Dakyodream/orbtrace_hw/hw/orbtrace_m26/net_length.md

# Net length

26.4998

26.5

DI: 12.9525
DO: 13.1981
CK: 13.1911
MS: 12.825

Trace
CLK 23.7894
D0 9.0235
D1 9.9449
D2 7.0862
D3 7.7114

26,5
26.656
