Dakyodream/orbtrace_hw/hw/orbtrace_m26/orbtrace_m26/orbtrace_m26.kicad_pcb

## KiCad design hw/orbtrace_m26/orbtrace_m26/orbtrace_m26.kicad_pcb (2026-08-20)

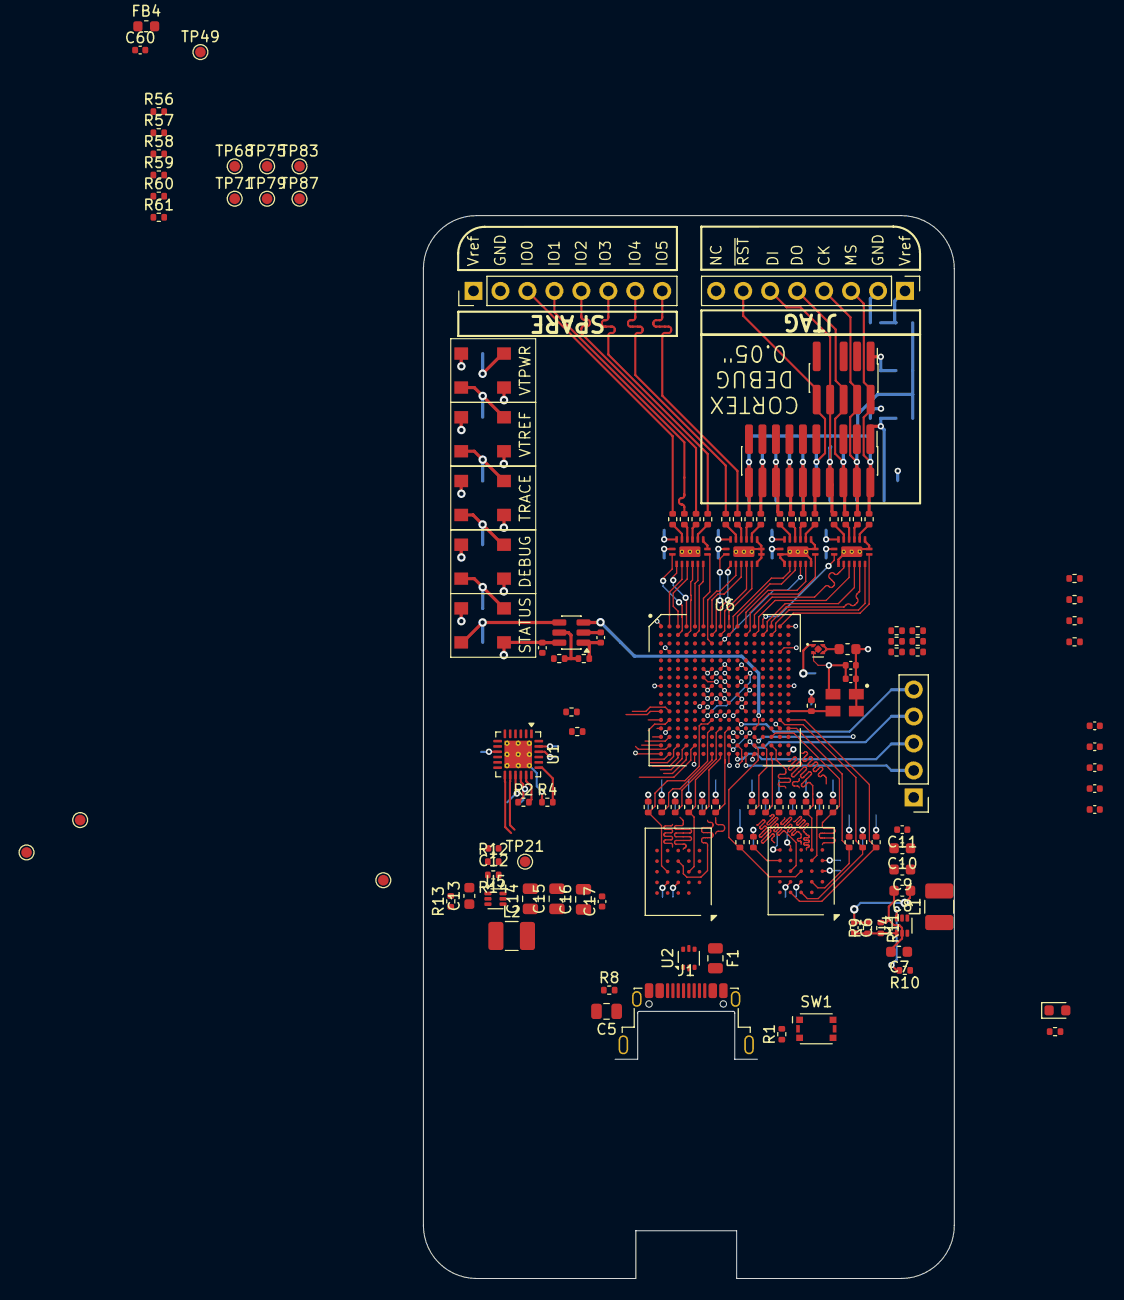
[picture p13: board orbtrace_m26.kicad_pcb from above]

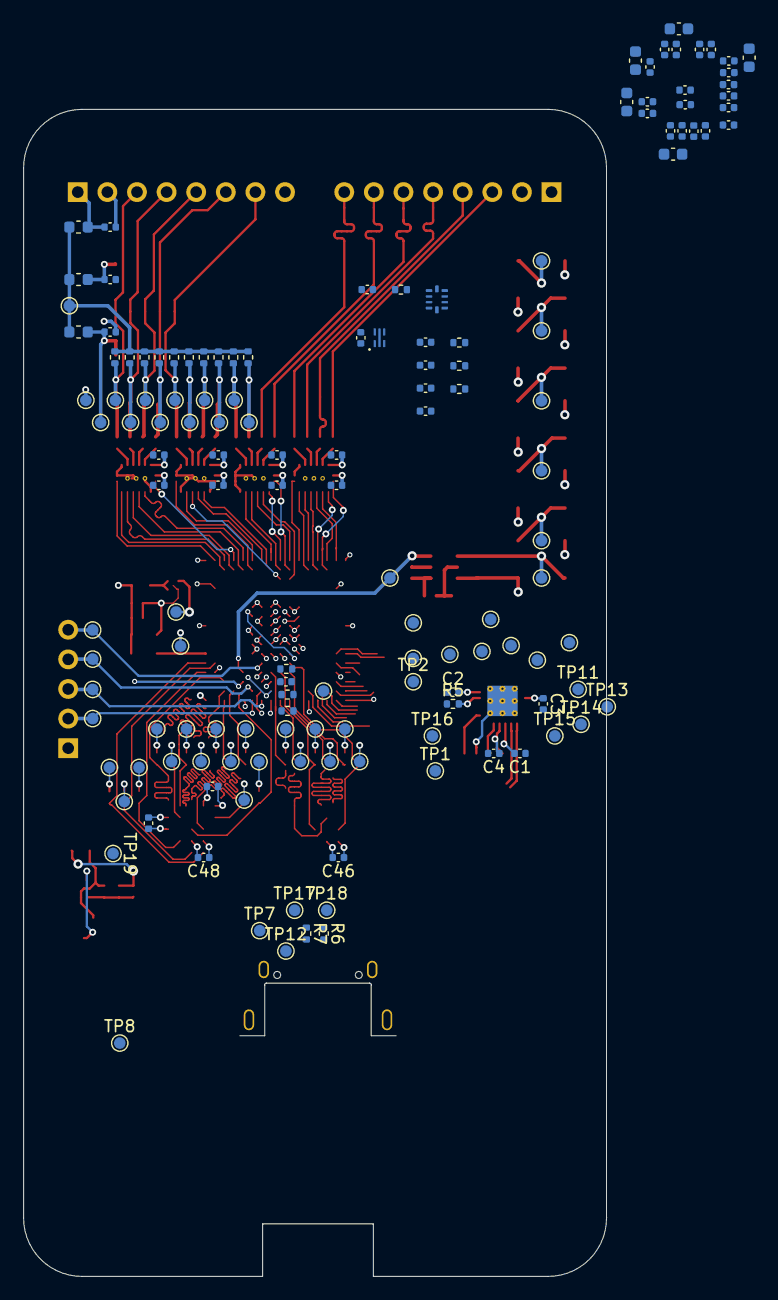
[picture p14: board orbtrace_m26.kicad_pcb from below]

Board: 4 copper layers, 50.0 x 100.1 mm, 273 parts (141 on the bottom side), 161 nets.

Parts:
C1, C2, C11, C17, C44: 1µF; C_0402_1005Metric
C3, C4, C18, C22, C23, C24, C25, C26, C27, C29, C30, C32, C33, C34, C35, C36, C37, C38, C39, C40, C41, C42, C43, C45, C46, C47, C48, C49, C50, C51, C52, C53, C54, C55, C56, C57, C58, C59, C60, C61, C62, C71, C72, C73, C74, C75, C76, C77: 100nF; C_0402_1005Metric
C5: 4.7nF; C_0805_2012Metric
C6, C12: 6.8pF; C_0402_1005Metric
C7, C13: 4.7µF; C_0603_1608Metric
C8, C9, C10, C19, C20, C21, C28, C31: 10µF; C_0603_1608Metric
C14, C15, C16: 22µF; C_0805_2012Metric
C63, C64, C65, C66: 470nF; C_0402_1005Metric
D1: GREEN; LED_0603_1608Metric
F1: 500mA; Fuse_0805_2012Metric
FB1, FB2, FB3, FB4, FB5: MMZ1005Y121CT000; L_0603_1608Metric
J1: USB_C_Receptacle_USB2.0_16P; USB_C_Receptacle_Amphenol_12401948E412A
J2: Conn_01x05; PinHeader_1x05_P2.54mm_Vertical
J3, J4: Conn_01x08; PinHeader_1x08_P2.54mm_Vertical
L1, L2: 2.2µH; L_1210_3225Metric_Pad1.42x2.65mm_HandSolder
R1, R5: 10k; R_0402_1005Metric
R2: 20k; R_0402_1005Metric
R3: 180Ω; R_0402_1005Metric
R4: 8.06k; R_0402_1005Metric
R6, R7: 5.1k; R_0402_1005Metric
R8: 1M; R_0402_1005Metric
R9: 453k; R_0402_1005Metric
R10, R13: 475k; R_0402_1005Metric
R11, R14, R38, R39, R40, R41, R44, R49, R52, R53, R54, R55, R56, R57, R58, R59, R60, R61: 100k; R_0402_1005Metric
R12: 82.5k; R_0402_1005Metric
R15, R16, R17, R18, R19, R20, R21, R22, R23, R24, R25, R26: 4.7k; R_0402_1005Metric
R27, R28, R29, R68, R69, R70, R71, R72, R73, R74, R75, R76, R77, R78, R79, R80, R81, R82, R83, R84, R85, R86: 0Ω; R_0402_1005Metric
R30, R31, R32, R33, R34, R35, R36, R37, R42, R43, R45, R46, R47, R48, R50, R51: 100Ω; R_0402_1005Metric
R62, R63, R64, R65, R66, R67: 1K; R_0402_1005Metric
SW1: SW_Push_Shielded; SW_Wurth_WS-TASV_435151014824
TP1, TP2, TP3, TP4, TP5, TP6, TP7, TP8, TP9, TP10, TP11, TP12, TP13, TP14, TP15, TP16, TP17, TP18, TP19, TP20, TP21, TP22, TP23, TP24, TP25, TP26, TP27, TP28, TP29, TP30, TP31, TP32, TP33, TP34, TP35, TP36, TP37, TP38, TP39, TP40, TP41, TP42, TP43, TP44, TP45, TP46, TP47, TP48, TP49, TP52, TP53, TP56, TP59, TP62, TP65, TP68, TP69, TP71, TP72, TP75, TP76, TP79, TP80, TP83, TP84, TP87, TP93, TP94, TP95, TP96, TP97, TP98, TP99, TP100, TP101, TP102, TP103: TestPoint_Pad_D1.0mm
U1: USB3343; QFN-24-1EP_4x4mm_P0.5mm_EP2.6x2.6mm_ThermalVias
U2: USBLC6-2P6; SOT-666
U3: TLV71325PDQN; Texas_X2SON-4_1x1mm_P0.65mm
U4, U5: TLV62568PDRL; SOT-563
U6: LFE5U-25F-6BG256C; lattice_caBGA-256_ECP5
U7: M24128-BFMH; UFDFPN5
U8: W956A8MBYA5I; BGA-24_6x8mm_Layout5x5_P1.0mm
U9: S25FL064LABBHV020; BGA-24_6x8mm_Layout5x5_P1.0mm
U10: SWD-TRACE-FTSH110; PinSocket_2x10_P1.27mm_JTAG
U11, U12, U14, U15: SN74AVC4T774-Q1; TI-WQFN-BQB0016B
U13: SWD-FTSH105; PinSocket_2x05_P1.27mm_JTAG
U16: TLA2024; RUG0010A
U17: SN74LVC1T45DBV; SOT-23-6
U18, U19, U20, U21, U22: WL-ICLED; LED_RGB_Wuerth-PLCC4_5x5mm_WL-ICLED
Y1: 831025497; CFPS-39

Connections:
+1V1: C12.1, C14.1, C15.1, C16.1, C17.1, C19.1, C20.1, C21.1, C22.1, C23.1, C24.1, C25.1, C26.1, C27.1, L2.2, R12.2, R62.2, TP21.1 (1_1), U6.G6 (VCC), U6.G7 (VCC), U6.G9 (VCC), U6.L8 (VCC), U6.L9 (VCC), U6.L10 (VCC)
+2V5: C28.1, C29.1, C30.1, R63.2, TP20.1 (1_1), U3.1 (OUT), U6.G11 (VCCAUX), U6.L7 (VCCAUX)
+3.3V: C3.1, C6.1, C8.1, C9.1, C10.1, C11.1, C31.1, C32.1, C33.1, C34.1, C35.1, C36.1, C37.1, C38.1, C39.1, C40.1, C41.1, C42.1, C43.1, C46.1, C47.1, C48.1, C49.1, C50.1, C52.1, C55.1, C57.1, C71.1, FB1.1, L1.2, R1.2, R9.2, R15.2, R16.2, R17.2, R18.2, R19.2, R21.2, R22.2, R23.2, R24.2, R25.2, R26.2, R64.2, R66.2, TP19.1 (1_1), U1.2 (CLKOUT), U1.9 (VDDIO), U3.3 (EN), U3.4 (IN), U6.F6 (VCCIO0), U6.F7 (VCCIO0), U6.F10 (VCCIO1), U6.F11 (VCCIO1), U6.H6 (VCCIO7), U6.H7 (VCCIO7), U6.J6 (VCCIO6), U6.J7 (VCCIO6), U6.K11 (VCCIO3), U6.L6 (VCCIO8), U6.L11 (VCCIO3), U7.1 (VCC), U8.B4 (VCC), U8.D1 (VCCQ), U8.E4 (VCCQ), U9.B4 (VCC), U11.16 (VCCA), U12.16 (VCCA), U14.16 (VCCA), U15.16 (VCCA), U17.1 (VCCA)
+5V: C4.1, C7.1, C13.1, C61.1, C72.1, C73.1, C74.1, C75.1, C76.1, C77.1, F1.1, R2.1, R3.2, R10.1, R13.1, TP7.1 (1_1), U1.16 (VBAT), U2.5 (VBUS), U4.3 (VIN), U4.5 (EN), U5.3 (VIN), U5.5 (EN), U16.8 (VDD), U17.6 (VCCB), U18.3 (VDD), U19.3 (VDD), U20.3 (VDD), U21.3 (VDD), U22.3 (VDD)
/FPGA/DONE: R22.1, TP22.1 (1_1), U6.P9 (DONE)
/USB/VBUS: F1.2, J1.A4 (VBUS), J1.A9 (VBUS), J1.B4 (VBUS), J1.B9 (VBUS), TP12.1 (1_1)
BTN: R1.1, SW1.2, TP8.1 (1_1), U6.P12 (PR47D)
CFG0: R24.1, R26.1, R27.2, R29.2, U6.N10 (CFG_0), U6.R10 (CFG_2)
CFG1: R25.1, R28.2, U6.P10 (CFG_1)
DEBUG_JTCK: U6.B13 (PT60A), U11.5 (A3)
DEBUG_JTDI: U6.A12 (PT53B), U11.3 (A1)
DEBUG_JTDO: U6.B12 (PT56A), U11.4 (A2)
DEBUG_JTMS: U6.A14 (PT65B), U11.6 (A4)
DEBUG_NRST: U6.A11 (PT35A), U14.6 (A4)
DIR_JTCK: U6.B14 (PT67A), U11.7 (DIR3)
DIR_JTDI: U6.A13 (PT65A), U11.1 (DIR1)
DIR_JTMS: U6.A15 (PT67B), U11.8 (DIR4)
DIR_NRST: U6.B11 (PT49A), U14.8 (DIR4)
GND: C1.1, C2.1, C3.2, C4.2, C5.2, C7.2, C8.2, C9.2, C10.2, C11.2, C13.2, C14.2, C15.2, C16.2, C17.2, C18.2, C19.2, C20.2, C21.2, C22.2, C23.2, C24.2, C25.2, C26.2, C27.2, C28.2, C29.2, C30.2, C31.2, C32.2, C33.2, C34.2, C35.2, C36.2, C37.2, C38.2, C39.2, C40.2, C41.2, C42.2, C43.2, C44.2, C45.2, C46.2, C47.2, C48.2, C49.2, C50.2, C51.2, C52.2, C53.2, C54.2, C55.2, C56.2, C57.2, C58.2, C59.2, C60.2, C61.2, C62.2, C63.2, C64.2, C65.2, C66.2, C71.2, C72.2, C73.2, C74.2, C75.2, C76.2, C77.2, D1.1 (K), J1.A1 (GND), J1.A12 (GND), J1.B1 (GND), J1.B12 (GND), J2.1, J3.2, J4.2, R4.1, R5.1, R6.1, R7.1, R8.1, R11.1, R14.1, R20.1, R27.1, R28.1, R29.1, R67.1, SW1.1, SW1.SH (B), TP100.1 (1_1), TP101.1 (1_1), TP102.1 (1_1), U1.25 (GND), U2.2 (GND), U3.2 (GND), U3.5 (PAD), U4.2 (GND), U5.2 (GND), U6.A1 (GND), U6.A16 (GND), U6.D2 (GND), U6.D15 (GND), U6.F8 (GND), U6.F9 (GND), U6.G8 (GND), U6.G10 (GND), U6.H1 (GND), U6.H8 (GND), U6.H9 (GND), U6.H10 (GND), U6.H11 (VCCIO2), U6.H16 (GND), U6.J8 (GND), U6.J9 (GND), U6.J10 (GND), U6.J11 (VCCIO2), U6.K6 (GND), U6.K7 (GND), U6.K8 (GND), U6.K9 (GND), U6.K10 (GND), U6.N2 (GND), U6.N15 (GND), U6.T1 (GND), U6.T5 (GND), U6.T12 (GND), U6.T16 (GND), U7.2 (VSS), U7.5 (~WC), U8.B1 (~CLK), U8.B3 (VSS), U8.C1 (VSSQ), U8.E5 (VSSQ), U9.B3 (GND), U10.3 (GND), U10.5 (GND), U10.9 (GNDDET), U10.15 (GND), U10.17 (GND), U10.19 (GND), U11.2 (DIR2), U11.9 (~OE), U11.10 (GND), U11.17 (TP), U12.7 (DIR3), U12.8 (DIR4), U12.9 (~OE), U12.10 (GND), U12.17 (TP), U13.3 (GND), U13.5 (GND), U13.9 (GNDDET), U14.1 (DIR1), U14.2 (DIR2), U14.7 (DIR3), U14.9 (~OE), U14.10 (GND), U14.17 (TP), U15.9 (~OE), U15.10 (GND), U15.17 (TP), U16.1 (ADDR), U16.3 (GND), U17.2 (GND), U18.1 (GND), U19.1 (GND), U20.1 (GND), U21.1 (GND), U22.1 (GND), Y1.2 (GND)
HRAM_CLK: R77.1, U6.N16 (PR32A), U8.B2 (CLK)
HRAM_CS: R76.1, U6.M15 (PR26D), U8.A3 (~CS)
HRAM_DQ0: R78.1, U6.T15 (PR38D), U8.D3 (DQ0)
HRAM_DQ1: R79.1, U6.P13 (PR41A), U8.D2 (DQ1)
HRAM_DQ2: R80.1, U6.T14 (PR41D), U8.C4 (DQ2)
HRAM_DQ3: R81.1, U6.R13 (PR41C), U8.D4 (DQ3)
HRAM_DQ4: R82.1, U6.T13 (PR44B), U8.D5 (DQ4)
HRAM_DQ5: R83.1, U6.R14 (PR41B), U8.E3 (DQ5)
HRAM_DQ6: R84.1, U6.R15 (PR38C), U8.E2 (DQ6)
HRAM_DQ7: R85.1, U6.P14 (PR38B), U8.E1 (DQ7)
HRAM_RST: R74.1, U6.M16 (PR26C), U8.A4 (~RESET)
HRAM_RWDS: R75.1, U6.R12 (PR44A), U8.C3 (RWDS)
JTCK: J2.3, R20.2, TP36.1 (1_1), U6.T10 (TCK)
JTDI: J2.4, R18.1, TP40.1 (1_1), U6.R11 (TDI)
JTDO: J2.5, R19.1, TP44.1 (1_1), U6.M10 (TDO)
JTMS: J2.2, R17.1, TP32.1 (1_1), U6.T11 (TMS)
LED_DATA: TP93.1 (1_1), U6.N12 (PR44D), U17.3 (A)
LED_EXT: TP99.1 (1_1), U22.4 (DOUT)
LED_START: TP94.1 (1_1), U17.4 (B), U18.2 (DIN)
unnamed: D1.2 (A), R3.1
unnamed: J1.A5 (CC1), R6.2
unnamed: J1.B5 (CC2), R7.2
unnamed: C5.1, J1.SH (SHIELD), R8.2
unnamed: C60.1, FB4.2, J3.1, TP49.1 (1_1)
unnamed: C62.1, FB5.1, J4.1
unnamed: R68.2, TP28.1 (1_1)
unnamed: R69.2, TP30.1 (1_1)
unnamed: R70.2, TP33.1 (1_1)
unnamed: R71.2, TP37.1 (1_1)
unnamed: R72.2, TP41.1 (1_1)
unnamed: R73.2, TP45.1 (1_1)
unnamed: R74.2, TP34.1 (1_1)
unnamed: R75.2, TP38.1 (1_1)
unnamed: R76.2, TP42.1 (1_1)
unnamed: R77.2, TP46.1 (1_1)
unnamed: R78.2, TP26.1 (1_1)
unnamed: R79.2, TP27.1 (1_1)
unnamed: R80.2, TP29.1 (1_1)
unnamed: R81.2, TP31.1 (1_1)
unnamed: R82.2, TP35.1 (1_1)
unnamed: R83.2, TP39.1 (1_1)
unnamed: R84.2, TP43.1 (1_1)
unnamed: R85.2, TP47.1 (1_1)
unnamed: R86.2, TP23.1 (1_1)
unnamed: C1.2, U1.15 (VDD33), U1.18 (ID)
unnamed: R4.2, U1.19 (RBIAS)
unnamed: R2.2, U1.17 (VBUS)
unnamed: C2.2, U1.23 (VDD18)
unnamed: C6.2, R9.1, R11.2, U4.1 (FB)
unnamed: R10.2, U4.6 (PG)
unnamed: L1.1, U4.4 (SW)
unnamed: C12.2, R12.1, R14.2, U5.1 (FB)
unnamed: R13.2, U5.6 (PG)
unnamed: L2.1, U5.4 (SW)
unnamed: R23.1, U6.T9 (INITN)
unnamed: C54.1, FB2.1, TP103.1 (1_1), U10.1 (VTREF)
unnamed: R34.1, U11.14 (B1)
unnamed: R36.1, U11.13 (B2)
unnamed: R30.1, U11.12 (B3)
unnamed: R32.1, U11.11 (B4)
unnamed: R35.1, U12.14 (B1)
unnamed: R37.1, U12.13 (B2)
unnamed: R31.1, U12.12 (B3)
unnamed: R33.1, U12.11 (B4)
unnamed: C59.1, FB3.2, U13.1 (VTREF)
unnamed: R47.1, U14.14 (B1)
unnamed: R50.1, U14.13 (B2)
unnamed: R42.1, U14.12 (B3)
unnamed: R45.1, U14.11 (B4)
unnamed: R48.1, U15.14 (B1)
unnamed: R51.1, U15.13 (B2)
unnamed: R43.1, U15.12 (B3)
unnamed: R46.1, U15.11 (B4)
unnamed: C63.1, R62.1, U16.4 (AN0)
unnamed: C64.1, R63.1, U16.5 (AN1)
unnamed: C65.1, R64.1, U16.6 (AN2)
unnamed: C66.1, R65.1, U16.7 (AN3)
unnamed: R66.1, R67.2, U17.5 (DIR)
unnamed: TP95.1 (1_1), U18.4 (DOUT), U19.2 (DIN)
unnamed: TP96.1 (1_1), U19.4 (DOUT), U20.2 (DIN)
unnamed: TP97.1 (1_1), U20.4 (DOUT), U21.2 (DIN)
unnamed: TP98.1 (1_1), U21.4 (DOUT), U22.2 (DIN)
unnamed: C44.1, C45.1, FB1.2, Y1.1 (EN), Y1.4 (+Vs)
PROGRAMN: C18.1, R21.1, TP48.1 (1_1), U6.P11 (PR47C), U6.R9 (PROGRAMN)
QSPI_CS: R73.1, U6.N8 (PB15A), U9.C2 (~CS)
QSPI_IO0: R68.1, U6.T8 (PB11B), U9.D3 (IO0)
QSPI_IO1: R69.1, U6.T7 (PB11A), U9.D2 (IO1)
QSPI_IO2: R70.1, U6.M7 (PB9B), U9.C4 (IO2)
QSPI_IO3: R71.1, U6.N7 (PB9A), U9.D4 (IO3)
QSPI_SCK: R72.1, U6.N9 (CCLK), U9.B2 (CLK)
SCL: R15.1, TP25.1 (1_1), U6.L2 (PL26B), U7.4 (SCL), U16.10 (SCL)
SDA: R16.1, TP24.1 (1_1), U6.L1 (PL26A), U7.3 (SDA), U16.9 (SDA)
SPARE_DIR0: U6.B3 (PT4B), U15.1 (DIR1)
SPARE_DIR1: U6.A4 (PT6B), U15.2 (DIR2)
SPARE_DIR2: U6.B5 (PT15B), U15.7 (DIR3)
SPARE_DIR3: U6.A6 (PT18B), U15.8 (DIR4)
SPARE_DIR4: U6.B7 (PT27B), U12.1 (DIR1)
SPARE_DIR5: U6.A8 (PT29B), U12.2 (DIR2)
SPARE_IO0: U6.A2 (PT4A), U15.3 (A1)
SPARE_IO1: U6.A3 (PT6A), U15.4 (A2)
SPARE_IO2: U6.B4 (PT11B), U15.5 (A3)
SPARE_IO3: U6.A5 (PT18A), U15.6 (A4)
SPARE_IO4: U6.C7 (PT27A), U12.3 (A1)
SPARE_IO5: U6.A7 (PT29A), U12.4 (A2)
SYS_CLK: R86.1, U6.L16 (PR26A), Y1.3 (out)
TRACE_CLK: U6.C8 (PT35A), U14.5 (A3)
TRACE_D0: U6.A10 (PT42B), U14.4 (A2)
TRACE_D1: U6.B9 (PT38A), U14.3 (A1)
TRACE_D2: U6.A9 (PT42A), U12.6 (A4)
TRACE_D3: U6.B8 (PT35B), U12.5 (A3)
ULPI_CLK: TP1.1 (1_1), U1.21 (REFCLK/XI), U6.R5 (PL44A)
ULPI_DATA0: TP5.1 (1_1), U1.4 (DATA0), U6.T2 (PL38D)
ULPI_DATA1: TP6.1 (1_1), U1.5 (DATA1), U6.R2 (PL38C)
ULPI_DATA2: TP9.1 (1_1), U1.6 (DATA2), U6.R1 (PL35B)
ULPI_DATA3: TP10.1 (1_1), U1.7 (DATA3), U6.P2 (PL32B)
ULPI_DATA4: TP11.1 (1_1), U1.8 (DATA4), U6.P1 (PL35A)
ULPI_DATA5: TP13.1 (1_1), U1.10 (DATA5), U6.N1 (PL32A)
ULPI_DATA6: TP14.1 (1_1), U1.11 (DATA6), U6.M2 (PL26D)
ULPI_DATA7: TP15.1 (1_1), U1.12 (DATA7), U6.M1 (PL26C)
ULPI_DIR: TP4.1 (1_1), U1.1 (DIR), U6.T3 (PL41D)
ULPI_NXT: TP3.1 (1_1), U1.3 (NXT), U6.R3 (PL41B)
ULPI_RESET: R5.2, TP16.1 (1_1), U1.22 (~RESETB), U6.T4 (PL44B)
ULPI_STP: TP2.1 (1_1), U1.24 (STP), U6.R4 (PL41C)
USB_D_N: J1.A7 (D-), J1.B7 (D-), TP18.1 (1_1), U1.14 (DM), U2.1 (IO1), U2.6 (IO1)
USB_D_P: J1.A6 (D+), J1.B6 (D+), TP17.1 (1_1), U1.13 (DP), U2.3 (IO2), U2.4 (IO2)
VTREF: C51.1, C53.1, C56.1, C58.1, FB2.2, FB3.1, FB4.1, FB5.2, R38.2, R39.2, R40.2, R41.2, R44.2, R49.2, R52.2, R53.2, R54.2, R55.2, R56.2, R57.2, R58.2, R59.2, R60.2, R61.2, R65.2, TP52.1 (1_1), U11.15 (VCCB), U12.15 (VCCB), U14.15 (VCCB), U15.15 (VCCB)
VT_DEBUG_JTCK: J4.4, R30.2, R40.1, TP59.1 (1_1), U10.4 (SWCLK), U13.4 (SWCLK)
VT_DEBUG_JTDI: J4.6, R34.2, R44.1, TP65.1 (1_1), U10.8 (NC_(JTDI)), U13.8 (NC_(JTDI))
VT_DEBUG_JTDO: J4.5, R36.2, R41.1, TP62.1 (1_1), U10.6 (SWO), U13.6 (SWO)
VT_DEBUG_JTMS: J4.3, R32.2, R39.1, TP56.1 (1_1), U10.2 (SWDIO), U13.2 (SWDIO)
VT_DEBUG_NRST: J4.7, R38.1, R45.2, TP53.1 (1_1), U10.10 (NRST), U13.10 (NRST)
VT_SPARE_IO0: J3.3, R48.2, R56.1, TP68.1 (1_1)
VT_SPARE_IO1: J3.4, R51.2, R57.1, TP71.1 (1_1)
VT_SPARE_IO2: J3.5, R43.2, R58.1, TP75.1 (1_1)
VT_SPARE_IO3: J3.6, R46.2, R59.1, TP79.1 (1_1)
VT_SPARE_IO4: J3.7, R35.2, R60.1, TP83.1 (1_1)
VT_SPARE_IO5: J3.8, R37.2, R61.1, TP87.1 (1_1)
VT_TRACE_CLK: R42.2, R49.1, TP69.1 (1_1), U10.12 (VT_TRACECLK)
VT_TRACE_D0: R50.2, R52.1, TP72.1 (1_1), U10.14 (TRACED0)
VT_TRACE_D1: R47.2, R53.1, TP76.1 (1_1), U10.16 (TRACED1)
VT_TRACE_D2: R33.2, R54.1, TP80.1 (1_1), U10.18 (TRACED2)
VT_TRACE_D3: R31.2, R55.1, TP84.1 (1_1), U10.20 (TRACED3)
