Dakyodream/orbtrace_hw/hw/orbtrace_mini_bis_kicad/connector_70p.kicad_sch

## KiCad design hw/orbtrace_mini_bis_kicad/connector_70p.kicad_sch (2026-08-03)

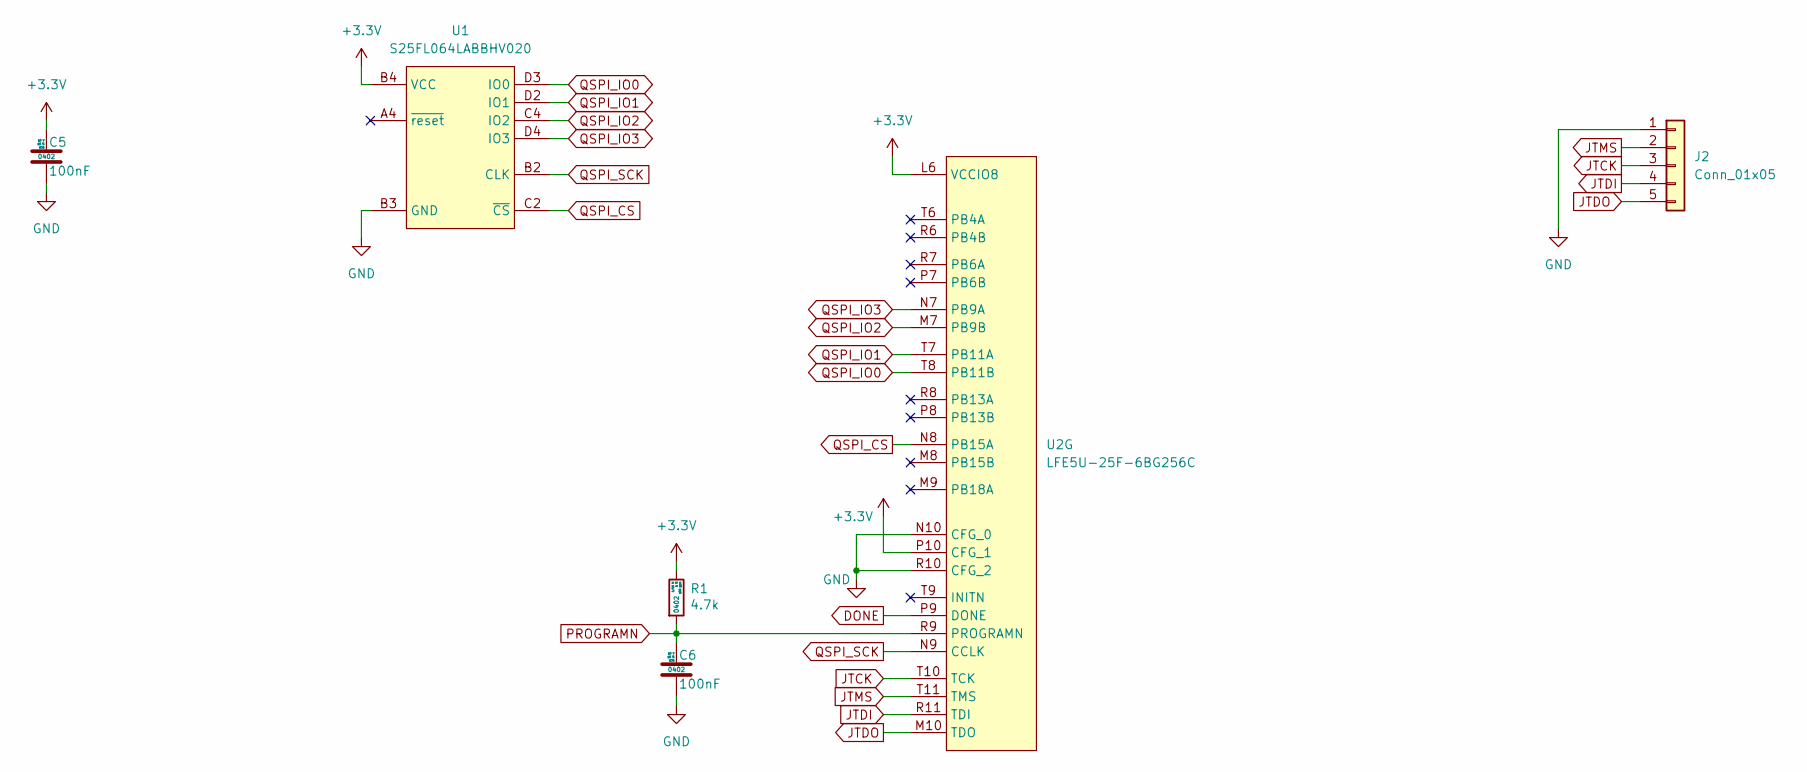
[picture p15: schematic connector_70p.kicad_sch]

Parts:
C5, C6: 100nF; Voltage rating DC 10 V; Tolerance 10 %
J2: Conn_01x05
R1: 4.7k; Tolerance 1 %
U1: S25FL064LABBHV020
U2: LFE5U-25F-6BG256C

Connections:
+3.3V: C5.1, R1.2, U1.B4 (VCC), U2.L6 (VCCIO8), U2.P10 (CFG_1)
DONE: U2.P9 (DONE)
GND: C5.2, C6.2, J2.1, U1.B3 (GND), U2.N10 (CFG_0), U2.R10 (CFG_2)
JTCK: J2.3, U2.T10 (TCK)
JTDI: J2.4, U2.R11 (TDI)
JTDO: J2.5, U2.M10 (TDO)
JTMS: J2.2, U2.T11 (TMS)
PROGRAMN: C6.1, R1.1, U2.R9 (PROGRAMN)
QSPI_CS: U1.C2 (~CS), U2.N8 (PB15A)
QSPI_IO0: U1.D3 (IO0), U2.T8 (PB11B)
QSPI_IO1: U1.D2 (IO1), U2.T7 (PB11A)
QSPI_IO2: U1.C4 (IO2), U2.M7 (PB9B)
QSPI_IO3: U1.D4 (IO3), U2.N7 (PB9A)
QSPI_SCK: U1.B2 (CLK), U2.N9 (CCLK)
