Dakyodream/orbtrace_hw/hw/orbtrace_mini_bis_kicad/fpga_2.kicad_sch

## KiCad design hw/orbtrace_mini_bis_kicad/fpga_2.kicad_sch (2026-08-03)

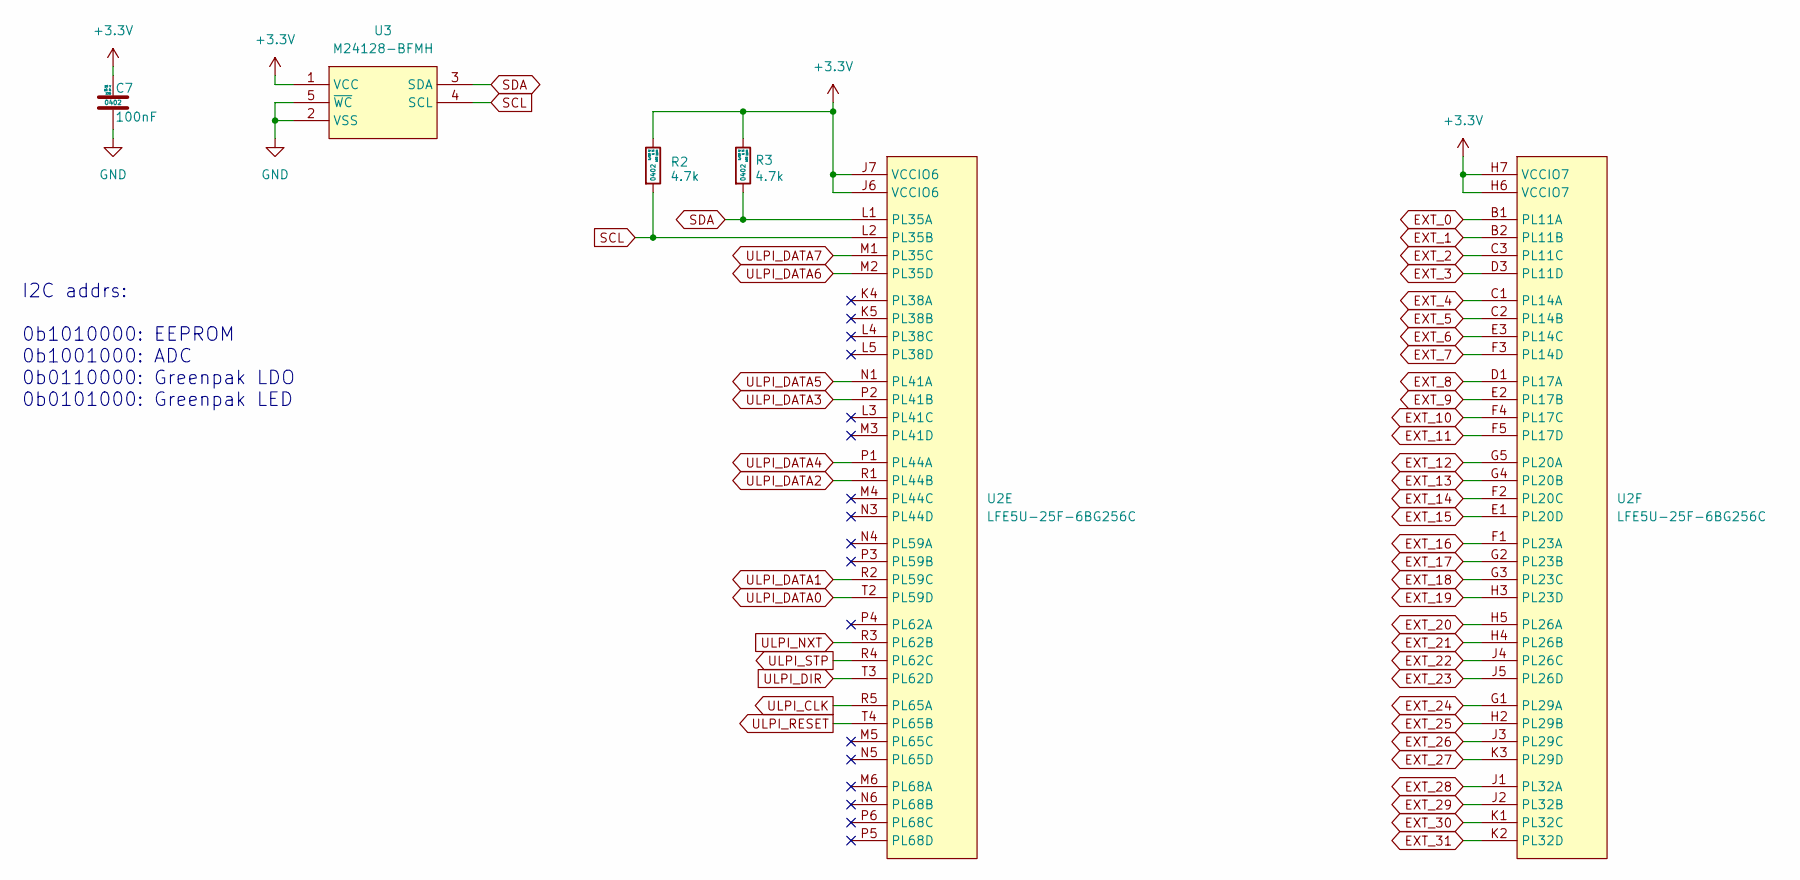
[picture p16: schematic fpga_2.kicad_sch]

Parts:
C7: 100nF; Voltage rating DC 10 V; Tolerance 10 %
R2, R3: 4.7k; Tolerance 1 %
U2: LFE5U-25F-6BG256C
U3: M24128-BFMH

Connections:
+3.3V: C7.1, R2.2, R3.2, U2.H6 (VCCIO7), U2.H7 (VCCIO7), U2.J6 (VCCIO6), U2.J7 (VCCIO6), U3.1 (VCC)
EXT_0: U2.B1 (PL11A)
EXT_1: U2.B2 (PL11B)
EXT_2: U2.C3 (PL11C)
EXT_3: U2.D3 (PL11D)
EXT_4: U2.C1 (PL14A)
EXT_5: U2.C2 (PL14B)
EXT_6: U2.E3 (PL14C)
EXT_7: U2.F3 (PL14D)
EXT_8: U2.D1 (PL17A)
EXT_9: U2.E2 (PL17B)
EXT_10: U2.F4 (PL17C)
EXT_11: U2.F5 (PL17D)
EXT_12: U2.G5 (PL20A)
EXT_13: U2.G4 (PL20B)
EXT_14: U2.F2 (PL20C)
EXT_15: U2.E1 (PL20D)
EXT_16: U2.F1 (PL23A)
EXT_17: U2.G2 (PL23B)
EXT_18: U2.G3 (PL23C)
EXT_19: U2.H3 (PL23D)
EXT_20: U2.H5 (PL26A)
EXT_21: U2.H4 (PL26B)
EXT_22: U2.J4 (PL26C)
EXT_23: U2.J5 (PL26D)
EXT_24: U2.G1 (PL29A)
EXT_25: U2.H2 (PL29B)
EXT_26: U2.J3 (PL29C)
EXT_27: U2.K3 (PL29D)
EXT_28: U2.J1 (PL32A)
EXT_29: U2.J2 (PL32B)
EXT_30: U2.K1 (PL32C)
EXT_31: U2.K2 (PL32D)
GND: C7.2, U3.2 (VSS), U3.5 (~WC)
SCL: R2.1, U2.L2 (PL35B), U3.4 (SCL)
SDA: R3.1, U2.L1 (PL35A), U3.3 (SDA)
ULPI_CLK: U2.R5 (PL65A)
ULPI_DATA0: U2.T2 (PL59D)
ULPI_DATA1: U2.R2 (PL59C)
ULPI_DATA2: U2.R1 (PL44B)
ULPI_DATA3: U2.P2 (PL41B)
ULPI_DATA4: U2.P1 (PL44A)
ULPI_DATA5: U2.N1 (PL41A)
ULPI_DATA6: U2.M2 (PL35D)
ULPI_DATA7: U2.M1 (PL35C)
ULPI_DIR: U2.T3 (PL62D)
ULPI_NXT: U2.R3 (PL62B)
ULPI_RESET: U2.T4 (PL65B)
ULPI_STP: U2.R4 (PL62C)

Notes on the sheet:
I2C addrs: 0b1010000: EEPROM 0b1001000: ADC 0b0110000: Greenpak LDO 0b0101000: Greenpak LED
