Dakyodream/orbtrace_hw/hw/orbtrace_mini_bis_kicad/fpga_3.kicad_sch

## KiCad design hw/orbtrace_mini_bis_kicad/fpga_3.kicad_sch (2026-08-03)

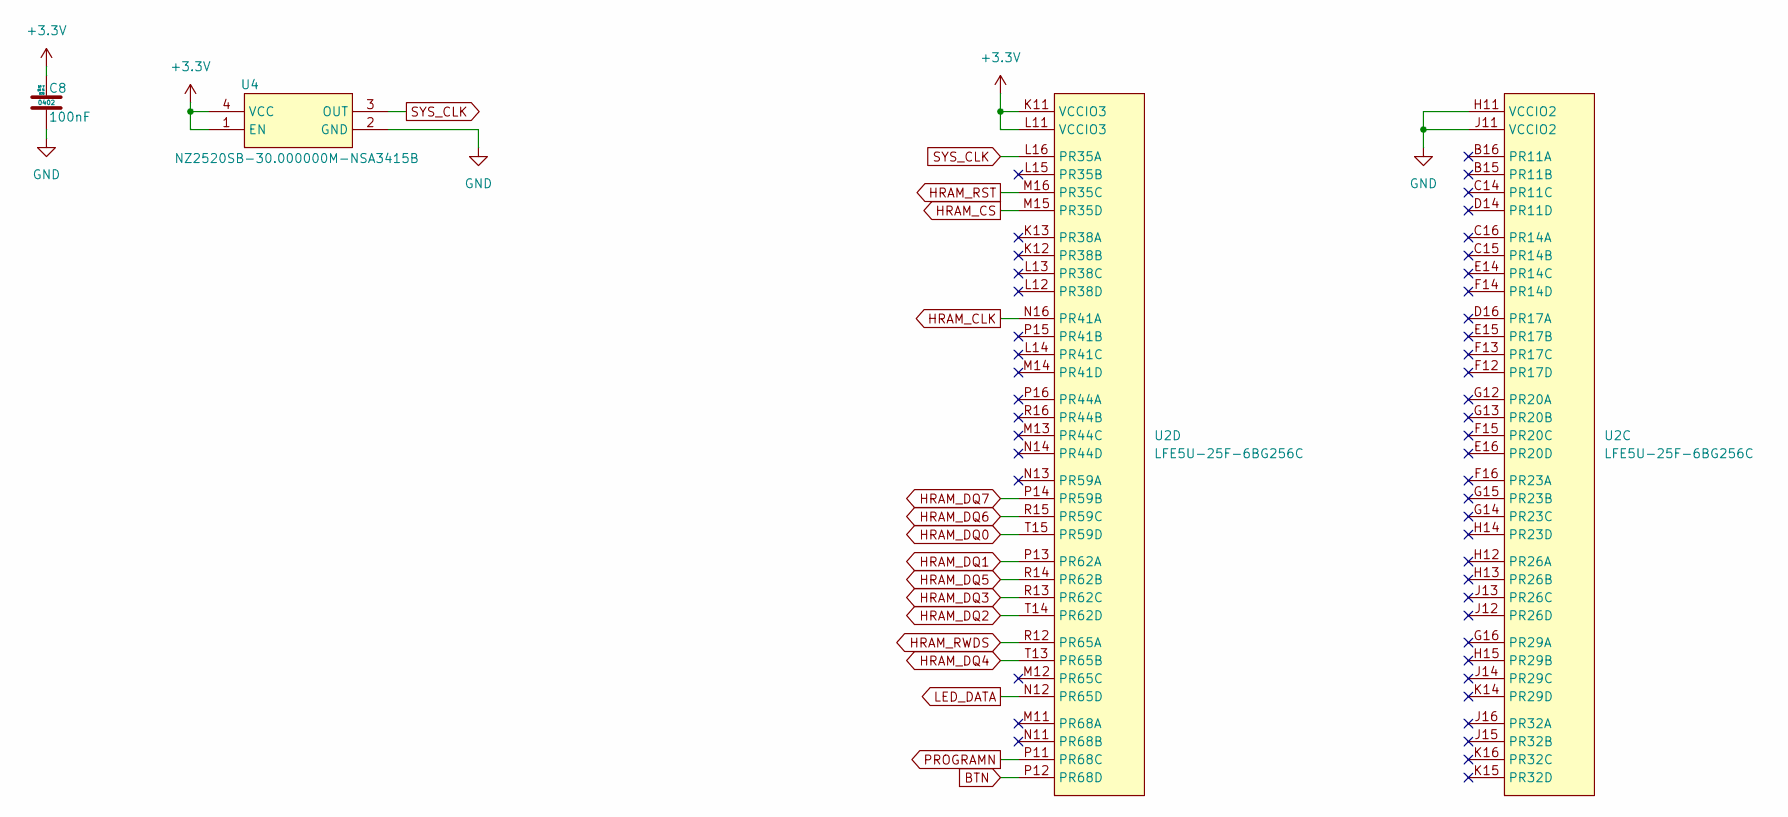
[picture p17: schematic fpga_3.kicad_sch]

Parts:
C8: 100nF; Voltage rating DC 10 V; Tolerance 10 %
U2: LFE5U-25F-6BG256C
U4: NZ2520SB-30.000000M-NSA3415B

Connections:
+3.3V: C8.1, U2.K11 (VCCIO3), U2.L11 (VCCIO3), U4.1 (EN), U4.4 (VCC)
BTN: U2.P12 (PR68D)
GND: C8.2, U2.H11 (VCCIO2), U2.J11 (VCCIO2), U4.2 (GND)
HRAM_CLK: U2.N16 (PR41A)
HRAM_CS: U2.M15 (PR35D)
HRAM_DQ0: U2.T15 (PR59D)
HRAM_DQ1: U2.P13 (PR62A)
HRAM_DQ2: U2.T14 (PR62D)
HRAM_DQ3: U2.R13 (PR62C)
HRAM_DQ4: U2.T13 (PR65B)
HRAM_DQ5: U2.R14 (PR62B)
HRAM_DQ6: U2.R15 (PR59C)
HRAM_DQ7: U2.P14 (PR59B)
HRAM_RST: U2.M16 (PR35C)
HRAM_RWDS: U2.R12 (PR65A)
LED_DATA: U2.N12 (PR65D)
PROGRAMN: U2.P11 (PR68C)
SYS_CLK: U2.L16 (PR35A), U4.3 (OUT)
