Dakyodream/orbtrace_hw/hw/orbtrace_mini_bis_kicad/hyperram.kicad_sch

## KiCad design hw/orbtrace_mini_bis_kicad/hyperram.kicad_sch (2026-08-03)

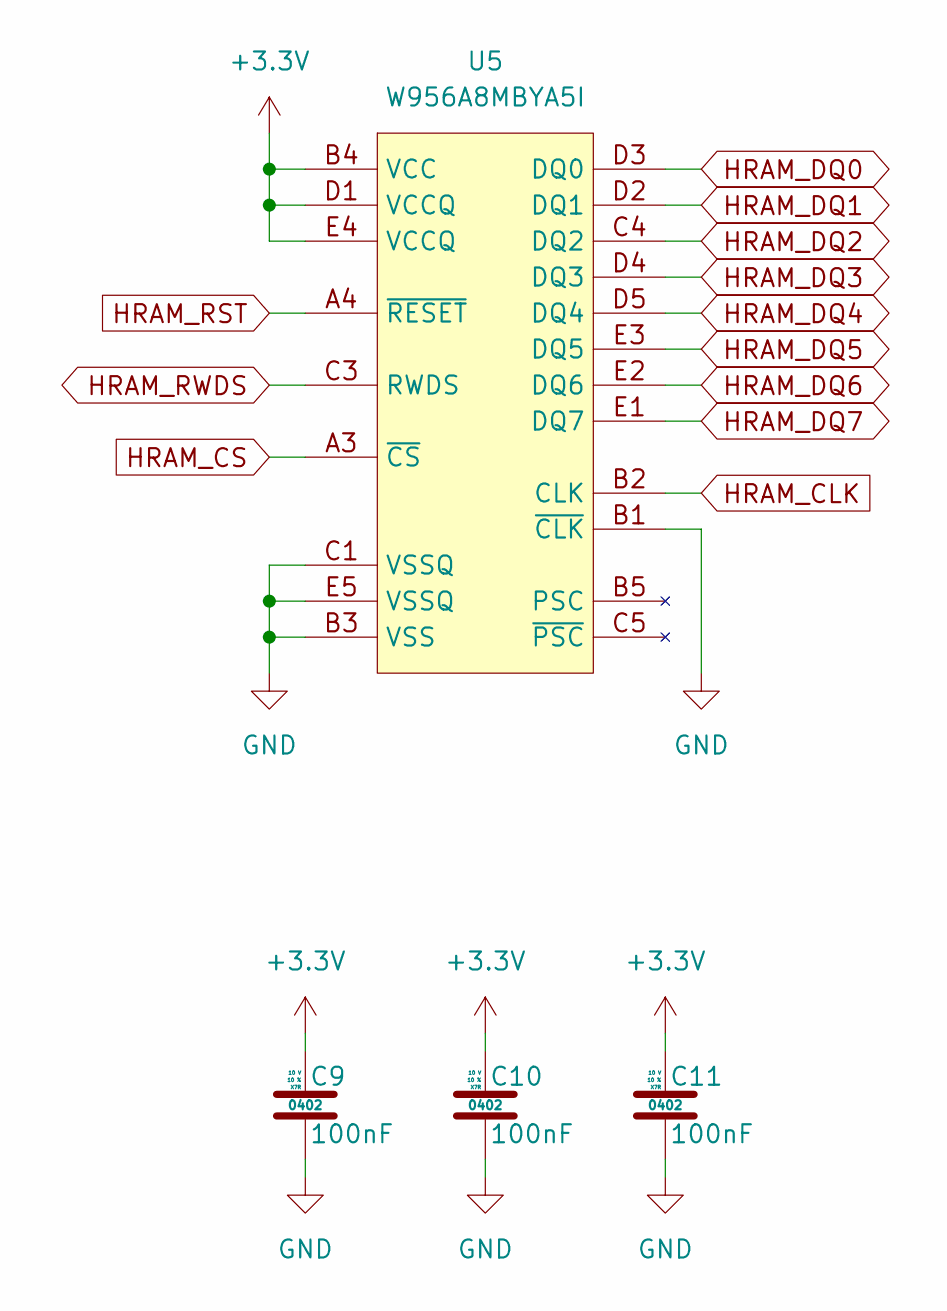
[picture p18: schematic hyperram.kicad_sch]

Parts:
C9, C10, C11: 100nF; Voltage rating DC 10 V; Tolerance 10 %
U5: W956A8MBYA5I

Connections:
+3.3V: C9.1, C10.1, C11.1, U5.B4 (VCC), U5.D1 (VCCQ), U5.E4 (VCCQ)
GND: C9.2, C10.2, C11.2, U5.B1 (~CLK), U5.B3 (VSS), U5.C1 (VSSQ), U5.E5 (VSSQ)
HRAM_CLK: U5.B2 (CLK)
HRAM_CS: U5.A3 (~CS)
HRAM_DQ0: U5.D3 (DQ0)
HRAM_DQ1: U5.D2 (DQ1)
HRAM_DQ2: U5.C4 (DQ2)
HRAM_DQ3: U5.D4 (DQ3)
HRAM_DQ4: U5.D5 (DQ4)
HRAM_DQ5: U5.E3 (DQ5)
HRAM_DQ6: U5.E2 (DQ6)
HRAM_DQ7: U5.E1 (DQ7)
HRAM_RST: U5.A4 (~RESET)
HRAM_RWDS: U5.C3 (RWDS)
