Dakyodream/orbtrace_hw/hw/orbtrace_mini_bis_kicad/led.kicad_sch

## KiCad design hw/orbtrace_mini_bis_kicad/led.kicad_sch (2026-08-03)

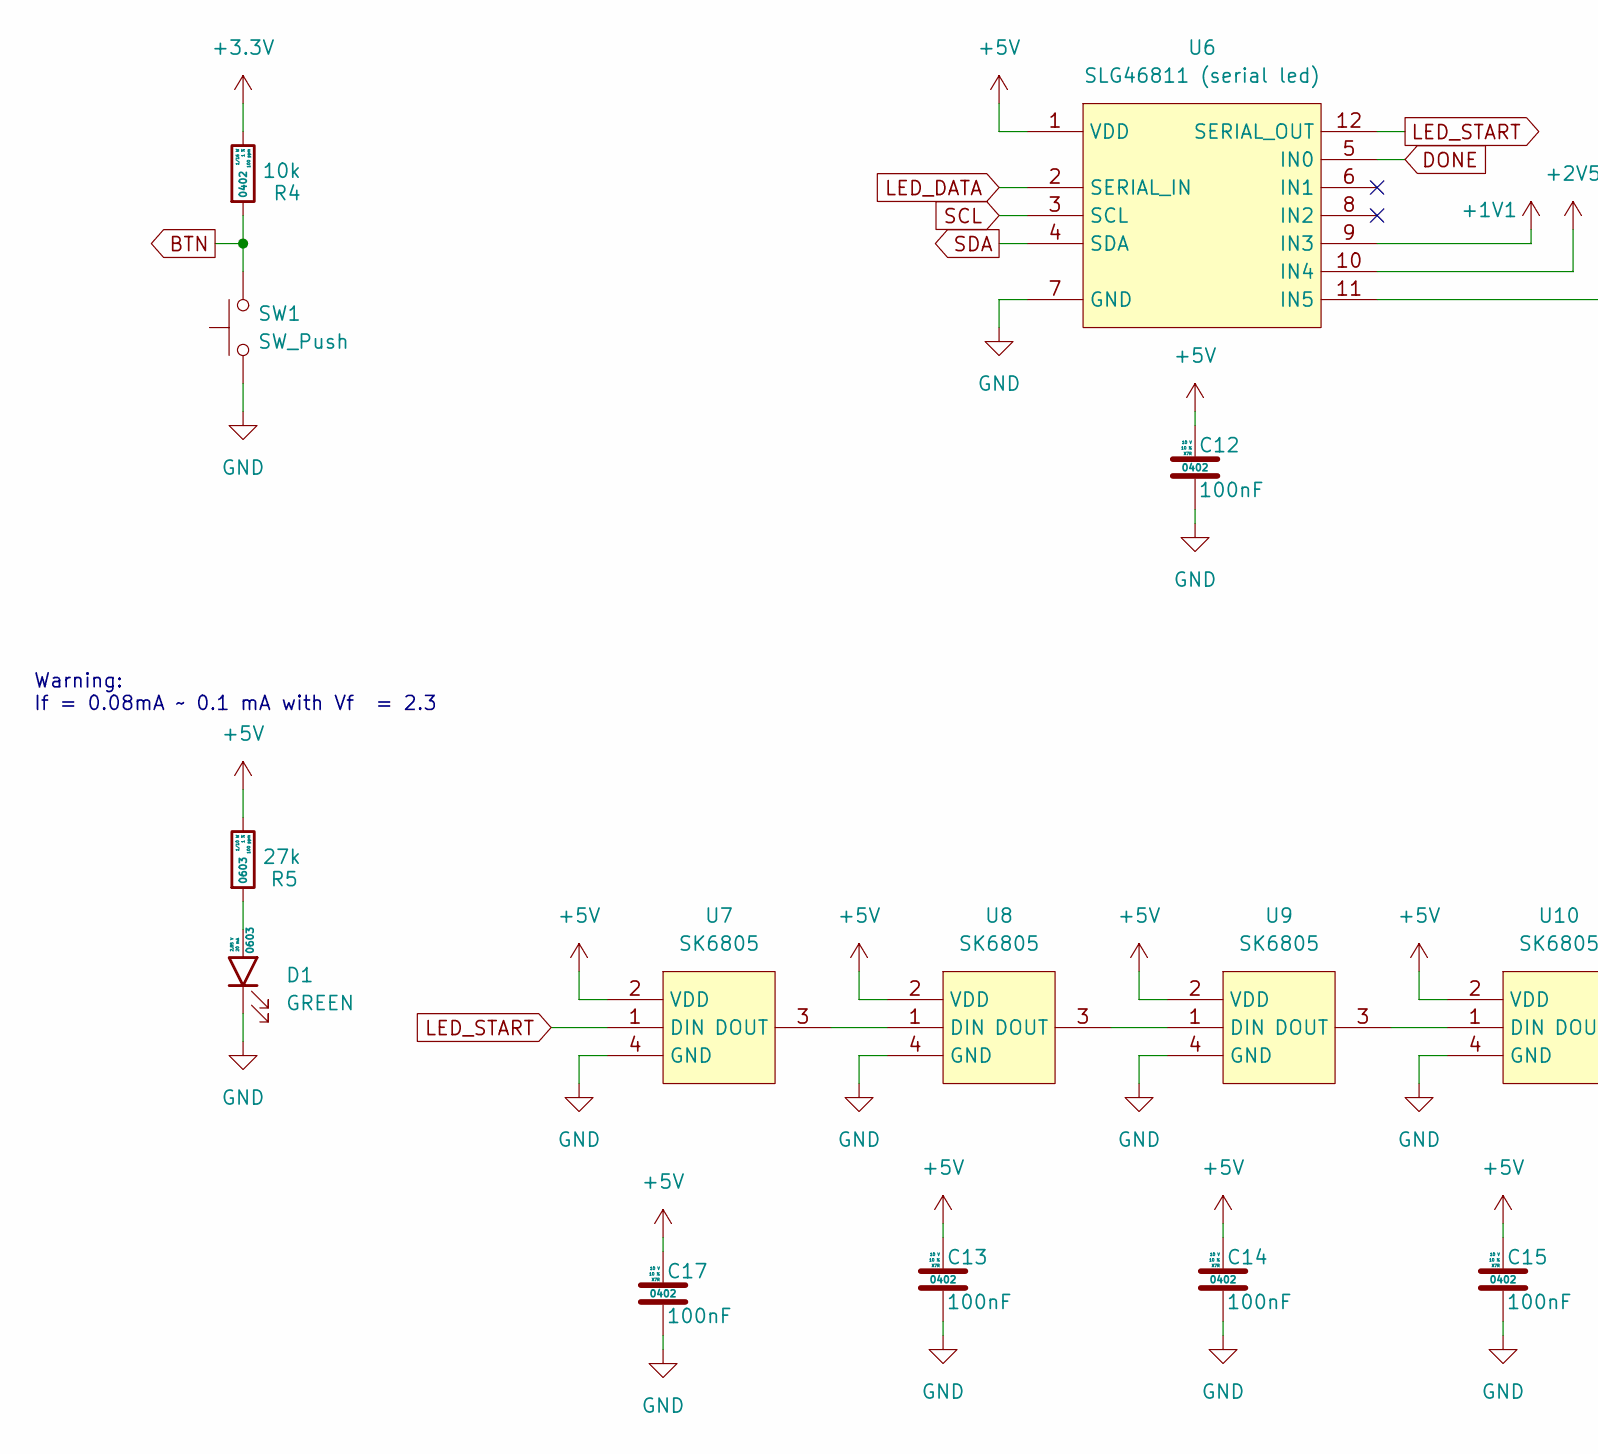
[picture p19: schematic led.kicad_sch, part in row 1, column 1]

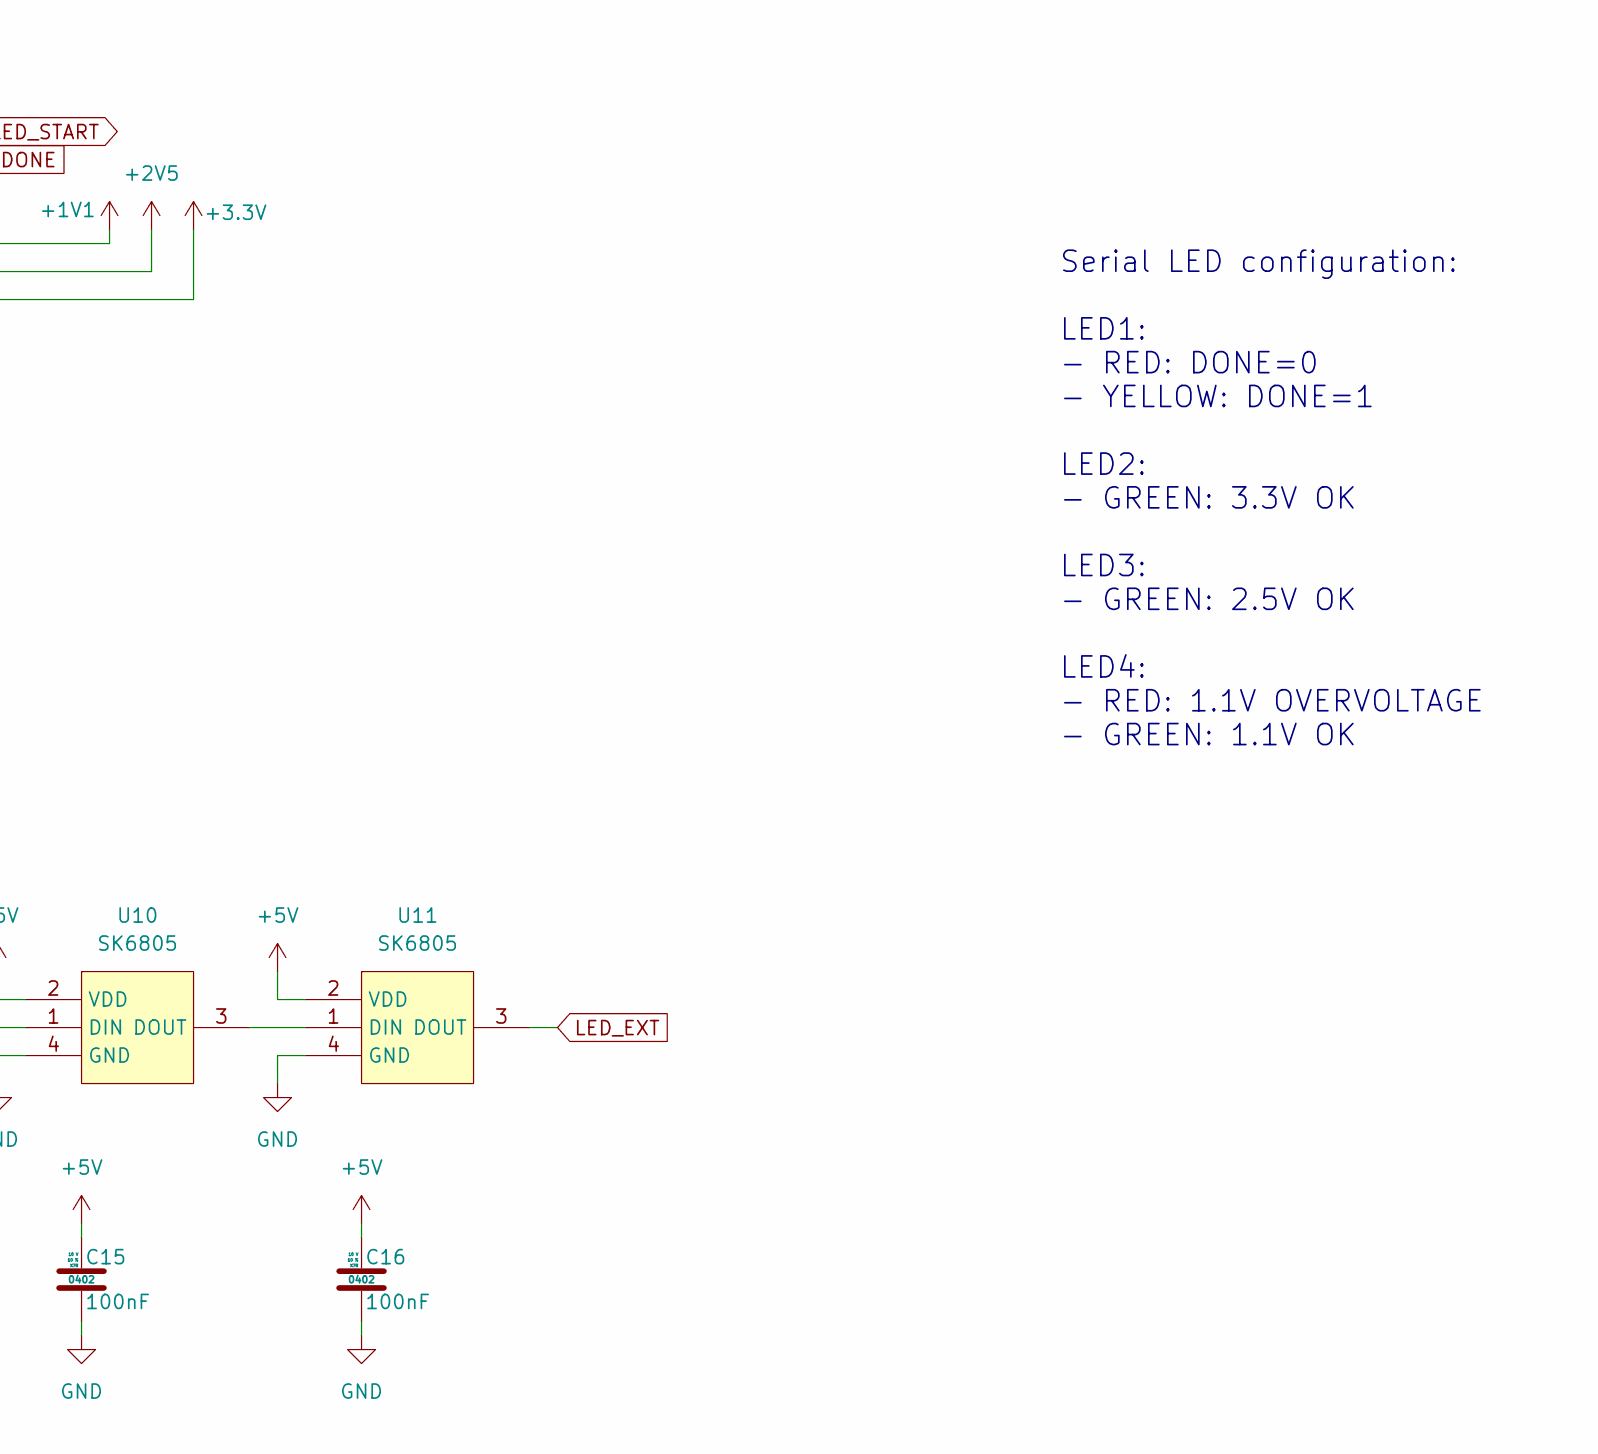
[picture p20: schematic led.kicad_sch, part in row 1, column 2]

Parts:
C12, C13, C14, C15, C16, C17: 100nF; Voltage rating DC 10 V; Tolerance 10 %
D1: GREEN; Forward Voltage 2.85 V
R4: 10k; Tolerance 1 %
R5: 27k; Tolerance 1 %
SW1: SW_Push
U6: SLG46811 (serial led)
U7, U8, U9, U10, U11: SK6805

Connections:
+1V1: U6.9 (IN3)
+2V5: U6.10 (IN4)
+3.3V: R4.2, U6.11 (IN5)
+5V: C12.1, C13.1, C14.1, C15.1, C16.1, C17.1, R5.2, U6.1 (VDD), U7.2 (VDD), U8.2 (VDD), U9.2 (VDD), U10.2 (VDD), U11.2 (VDD)
BTN: R4.1, SW1.2
DONE: U6.5 (IN0)
GND: C12.2, C13.2, C14.2, C15.2, C16.2, C17.2, D1.1 (K), SW1.1, U6.7 (GND), U7.4 (GND), U8.4 (GND), U9.4 (GND), U10.4 (GND), U11.4 (GND)
LED_DATA: U6.2 (SERIAL_IN)
LED_EXT: U11.3 (DOUT)
LED_START: U6.12 (SERIAL_OUT), U7.1 (DIN)
unnamed: D1.2 (A), R5.1
unnamed: U7.3 (DOUT), U8.1 (DIN)
unnamed: U8.3 (DOUT), U9.1 (DIN)
unnamed: U9.3 (DOUT), U10.1 (DIN)
unnamed: U10.3 (DOUT), U11.1 (DIN)
SCL: U6.3 (SCL)
SDA: U6.4 (SDA)

Notes on the sheet:
Serial LED configuration: LED1: - RED: DONE=0 - YELLOW: DONE=1 LED2: - GREEN: 3.3V OK LED3: - GREEN: 2.5V OK LED4: - RED: 1.1V OVERVOLTAGE - GREEN: 1.1V OK
Warning: If = 0.08mA ~ 0.1 mA with Vf = 2.3
