Dakyodream/orbtrace_hw/hw/orbtrace_mini_bis_kicad/orbtrace_mini_kicad_base.kicad_sch

## KiCad design hw/orbtrace_mini_bis_kicad/orbtrace_mini_kicad_base.kicad_sch (2026-08-03)

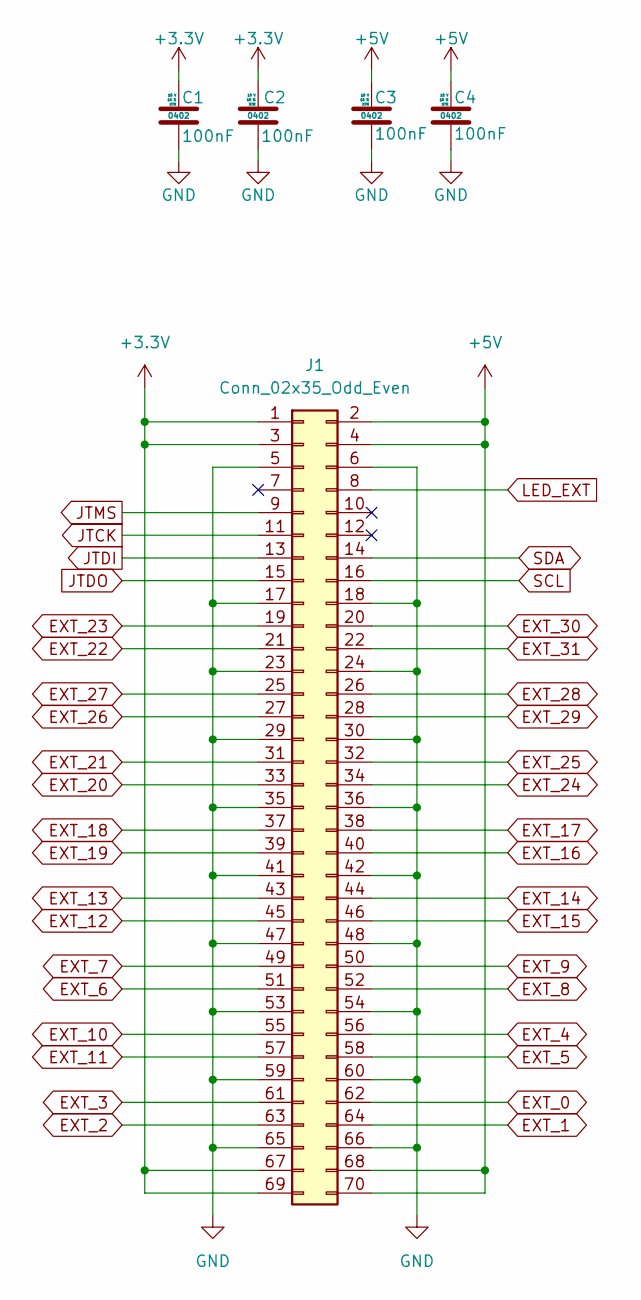
[picture p21: schematic orbtrace_mini_kicad_base.kicad_sch]

Parts:
C1, C2, C3, C4: 100nF; Voltage rating DC 10 V; Tolerance 10 %
J1: Conn_02x35_Odd_Even

Connections:
+3.3V: C1.1, C2.1, J1.1, J1.3, J1.67, J1.69
+5V: C3.1, C4.1, J1.2, J1.4, J1.68, J1.70
EXT_0: J1.62
EXT_1: J1.64
EXT_2: J1.63
EXT_3: J1.61
EXT_4: J1.56
EXT_5: J1.58
EXT_6: J1.51
EXT_7: J1.49
EXT_8: J1.52
EXT_9: J1.50
EXT_10: J1.55
EXT_11: J1.57
EXT_12: J1.45
EXT_13: J1.43
EXT_14: J1.44
EXT_15: J1.46
EXT_16: J1.40
EXT_17: J1.38
EXT_18: J1.37
EXT_19: J1.39
EXT_20: J1.33
EXT_21: J1.31
EXT_22: J1.21
EXT_23: J1.19
EXT_24: J1.34
EXT_25: J1.32
EXT_26: J1.27
EXT_27: J1.25
EXT_28: J1.26
EXT_29: J1.28
EXT_30: J1.20
EXT_31: J1.22
GND: C1.2, C2.2, C3.2, C4.2, J1.5, J1.6, J1.17, J1.18, J1.23, J1.24, J1.29, J1.30, J1.35, J1.36, J1.41, J1.42, J1.47, J1.48, J1.53, J1.54, J1.59, J1.60, J1.65, J1.66
JTCK: J1.11
JTDI: J1.13
JTDO: J1.15
JTMS: J1.9
LED_EXT: J1.8
SCL: J1.16
SDA: J1.14
