Dakyodream/orbtrace_hw/hw/orbtrace_mini_bis_kicad/power.kicad_sch

## KiCad design hw/orbtrace_mini_bis_kicad/power.kicad_sch (2026-08-03)

Schematic: power.kicad_sch

Parts:
C18, C19, C20, C21, C22, C23, C28, C29, C30, C31, C32, C33: 100nF; Voltage rating DC 10 V; Tolerance 10 %
C24, C34: 4.7µF; Voltage rating DC 10 V; Tolerance 10 %
C25: 6.8pF; Voltage rating DC 10 V; Tolerance 10 %
C26: 10µF; Voltage rating DC 10 V; Tolerance 10 %
C27: 1µF; Voltage rating DC 10 V; Tolerance 10 %
C35: 6.8pF; Voltage rating DC 6.3 V; Tolerance 10 %
C36, C37: 22µF; Voltage rating DC 4 V; Tolerance 10 %
C38: 1µF; Voltage rating DC 4 V; Tolerance 10 %
L1, L2: 2.2µH; Tolerance 20 %
R6: 210k; Tolerance 1 %
R7: 47k; Tolerance 1 %
R8: 84.5k; Tolerance 1 %
R9: 100k; Tolerance 1 %
U2: LFE5U-25F-6BG256C
U12, U13: TLV62569DRL
U14: TLV71325PDQN

Connections:
+1V1: C18.1, C19.1, C20.1, C21.1, C35.1, C36.1, C37.1, C38.1, L2.2, R8.2, U2.G6 (VCC), U2.G7 (VCC), U2.G9 (VCC), U2.L8 (VCC), U2.L9 (VCC), U2.L10 (VCC)
+2V5: C22.1, C23.1, U2.G11 (VCCAUX), U2.L7 (VCCAUX), U14.1 (OUT)
+3.3V: C25.1, C26.1, C27.1, C28.1, C29.1, C30.1, C31.1, C32.1, C33.1, L1.2, R6.2, U14.3 (EN), U14.4 (IN)
+5V: C24.1, C34.1, U12.3 (VIN), U12.5 (EN), U13.3 (VIN), U13.5 (EN)
GND: C18.2, C19.2, C20.2, C21.2, C22.2, C23.2, C24.2, C26.2, C27.2, C28.2, C29.2, C30.2, C31.2, C32.2, C33.2, C34.2, C36.2, C37.2, C38.2, R7.1, R9.1, U2.A1 (GND), U2.A16 (GND), U2.D2 (GND), U2.D15 (GND), U2.F8 (GND), U2.F9 (GND), U2.G8 (GND), U2.G10 (GND), U2.H1 (GND), U2.H8 (GND), U2.H9 (GND), U2.H10 (GND), U2.H16 (GND), U2.J8 (GND), U2.J9 (GND), U2.J10 (GND), U2.K6 (GND), U2.K7 (GND), U2.K8 (GND), U2.K9 (GND), U2.K10 (GND), U2.N2 (GND), U2.N15 (GND), U2.T1 (GND), U2.T5 (GND), U2.T12 (GND), U2.T16 (GND), U12.2 (GND), U13.2 (GND), U14.2 (GND), U14.PAD
unnamed: C25.2, R6.1, R7.2, U12.1 (FB)
unnamed: C35.2, R8.1, R9.2, U13.1 (FB)
unnamed: L1.1, U12.4 (SW)
unnamed: L2.1, U13.4 (SW)

Notes on the sheet:
Warning: Capa properties
f_{sw} = 1.5 MHz
