Dakyodream/orbtrace_hw/hw/orbtrace_mini_bis_kicad/target_io.kicad_sch

## KiCad design hw/orbtrace_mini_bis_kicad/target_io.kicad_sch (2026-08-03)

Schematic: target_io.kicad_sch

Parts:
C39, C40, C41, C42, C43, C44: 100nF; Voltage rating DC 10 V; Tolerance 10 %
FB1, FB2, FB3, FB4, FB5, FB6: FerriteBead
J3, J4: Conn_01x08
R10, R11, R12, R13, R14, R15, R16, R17, R18, R19, R20, R21, R22, R23, R24, R25: 100k; Tolerance 1 %
U15: SWD-TRACE-FTSH110
U16: SWD-FTSH105

Connections:
GND: C39.2, C40.2, C41.2, C42.2, C43.2, C44.2, J3.2, J4.2, U15.3 (GND), U15.5 (GND), U15.9 (GNDDET), U15.15 (GND), U15.17 (GND), U15.19 (GND), U16.3 (GND), U16.5 (GND), U16.9 (GNDDET)
unnamed: C39.1, FB2.2, J3.1
unnamed: C40.1, FB3.1, U15.11 (TPWR), U15.13 (TPWR)
unnamed: C41.1, FB1.1, U15.1 (VTREF)
unnamed: C42.1, FB4.1, J4.8
unnamed: C43.1, FB5.2, J4.1
unnamed: C44.1, FB6.2, U16.1 (VTREF)
VTPWR: FB3.2, FB4.2
VTREF: FB1.2, FB2.1, FB5.1, FB6.1, R10.2, R11.2, R12.2, R13.2, R14.2, R15.2, R16.2, R17.2, R18.2, R19.2, R20.2, R21.2, R22.2, R23.2, R24.2, R25.2
VT_DEBUG_JTCK: J4.4, R12.1, U15.4 (SWCLK), U16.4 (SWCLK)
VT_DEBUG_JTDI: J4.6, R14.1, U15.8 (NC_(JTDI)), U16.8 (NC_(JTDI))
VT_DEBUG_JTDO: J4.5, R13.1, U15.6 (SWO), U16.6 (SWO)
VT_DEBUG_JTMS: J4.3, R11.1, U15.2 (SWDIO), U16.2 (SWDIO)
VT_DEBUG_NRST: J4.7, R10.1, U15.10 (NRST), U16.10 (NRST)
VT_SPARE_IO0: J3.3, R20.1
VT_SPARE_IO1: J3.4, R21.1
VT_SPARE_IO2: J3.5, R22.1
VT_SPARE_IO3: J3.6, R23.1
VT_SPARE_IO4: J3.7, R24.1
VT_SPARE_IO5: J3.8, R25.1
VT_TRACE_CLK: R15.1, U15.12 (VT_TRACECLK)
VT_TRACE_D0: R16.1, U15.14 (TRACED0)
VT_TRACE_D1: R17.1, U15.16 (TRACED1)
VT_TRACE_D2: R18.1, U15.18 (TRACED2)
VT_TRACE_D3: R19.1, U15.20 (TRACED3)
