Dakyodream/orbtrace_hw/hw/orbtrace_mini_bis_kicad/target_power.kicad_sch

## KiCad design hw/orbtrace_mini_bis_kicad/target_power.kicad_sch (2026-08-03)

Schematic: target_power.kicad_sch

Parts:
C45, C46: 10µF; Voltage rating DC 10 V; Tolerance 10 %
C47, C51: 100nF; Voltage rating DC 10 V; Tolerance 10 %
C48: 4.7µF; Voltage rating DC 10 V; Tolerance 10 %
C49, C50, C52, C53, C54, C55: 470nF; Voltage rating DC 10 V; Tolerance 10 %
FB7: FerriteBead
R26: 1R; Tolerance 1 %
R27: 1R; Tolerance _ %
R28, R29, R30, R31: 1k; Tolerance 1 %
U17: SLG46582_DUAL_LDO
U18: MAX40200AUK; SOT-23-5
U19: TLA2024

Connections:
+5V: U18.1 (VDD), U18.3 (EN)
GND: C45.2, C46.2, C47.2, C48.2, C51.2, C52.2, C53.2, C54.2, C55.2, U17.17 (AGND), U17.20 (GND), U18.2 (GND), U19.1 (ADDR), U19.3 (GND)
unnamed: C45.1, R26.1, R28.2, U17.11 (VOUT0), U17.13 (VOUT0)
unnamed: C46.1, R27.1, R30.2, U17.14 (VOUT1), U17.16 (VOUT1)
unnamed: C49.1, C52.1, R28.1, U19.4 (AN0)
unnamed: C49.2, C53.1, R29.1, U19.5 (AN1)
unnamed: C50.1, C54.1, R30.1, U19.6 (AN2)
unnamed: C50.2, C55.1, R31.1, U19.7 (AN3)
unnamed: C51.1, FB7.2, U19.8 (VDD)
SCL: U17.8 (SCL), U19.10 (SCL)
SDA: U17.9 (SDA), U19.9 (SDA)
V5T: C47.1, C48.1, FB7.1, U17.7 (VDD), U17.12 (VIN0), U17.15 (VIN1), U18.5 (OUT)
VTPWR: R27.2, R31.2
VTPWR_EN: U17.1 (EN1)
VTPWR_FAULT: U17.3 (~FAULT1)
VTPWR_SEL: U17.2 (SEL1)
VTREF: R26.2, R29.2
VTREF_EN: U17.6 (EN0)
VTREF_FAULT: U17.4 (~FAULT0)
VTREF_SEL: U17.5 (SEL0)

Notes on the sheet:
Danger : 1/4 W < 1.5W (5V * 300mA)
300 mA
