Dakyodream/orbtrace_hw/hw/orbtrace_mini_bis_kicad/target_vt.kicad_sch

## KiCad design hw/orbtrace_mini_bis_kicad/target_vt.kicad_sch (2026-08-03)

Schematic: target_vt.kicad_sch

Parts:
C56, C57, C58, C59, C60, C61, C62, C63, C64, C65, C66, C67, C68, C69, C70, C71: 100nF; Voltage rating DC 10 V; Tolerance 10 %
R32, R33, R34, R35, R36, R37, R38, R39, R40, R41, R42, R43, R44, R45, R46, R47: 100R; Tolerance 1 %
U20, U21, U22, U23, U24, U25, U26, U27: SN74AVC2T245

Connections:
+3.3V: C56.1, C57.1, C58.1, C59.1, C60.1, C61.1, C62.1, C63.1, U20.7 (VCCA), U21.7 (VCCA), U22.7 (VCCA), U23.7 (VCCA), U24.7 (VCCA), U25.7 (VCCA), U26.7 (VCCA), U27.7 (VCCA)
DEBUG_JTCK: U20.8 (A1)
DEBUG_JTDI: U22.8 (A1)
DEBUG_JTDO: U22.9 (A2)
DEBUG_JTMS: U20.9 (A2)
DEBUG_NRST: U24.9 (A2)
DIR_JTCK: U20.10 (DIR1)
DIR_JTDI: U22.10 (DIR1)
DIR_JTMS: U20.1 (DIR2)
DIR_NRST: U24.1 (DIR2)
GND: C56.2, C57.2, C58.2, C59.2, C60.2, C61.2, C62.2, C63.2, C64.2, C65.2, C66.2, C67.2, C68.2, C69.2, C70.2, C71.2, U20.2 (~OE), U20.3 (GND), U21.2 (~OE), U21.3 (GND), U22.1 (DIR2), U22.2 (~OE), U22.3 (GND), U23.2 (~OE), U23.3 (GND), U24.2 (~OE), U24.3 (GND), U24.10 (DIR1), U25.2 (~OE), U25.3 (GND), U26.1 (DIR2), U26.2 (~OE), U26.3 (GND), U26.10 (DIR1), U27.1 (DIR2), U27.2 (~OE), U27.3 (GND), U27.10 (DIR1)
unnamed: R32.1, U20.5 (B1)
unnamed: R33.1, U21.5 (B1)
unnamed: R34.1, U20.4 (B2)
unnamed: R35.1, U21.4 (B2)
unnamed: R36.1, U22.5 (B1)
unnamed: R37.1, U23.5 (B1)
unnamed: R38.1, U22.4 (B2)
unnamed: R39.1, U23.4 (B2)
unnamed: R40.1, U24.5 (B1)
unnamed: R41.1, U25.5 (B1)
unnamed: R42.1, U24.4 (B2)
unnamed: R43.1, U25.4 (B2)
unnamed: R44.1, U26.5 (B1)
unnamed: R45.1, U26.4 (B2)
unnamed: R46.1, U27.5 (B1)
unnamed: R47.1, U27.4 (B2)
SPARE_DIR0: U25.10 (DIR1)
SPARE_DIR1: U25.1 (DIR2)
SPARE_DIR2: U23.10 (DIR1)
SPARE_DIR3: U23.1 (DIR2)
SPARE_DIR4: U21.10 (DIR1)
SPARE_DIR5: U21.1 (DIR2)
SPARE_IO0: U25.8 (A1)
SPARE_IO1: U25.9 (A2)
SPARE_IO2: U23.8 (A1)
SPARE_IO3: U23.9 (A2)
SPARE_IO4: U21.8 (A1)
SPARE_IO5: U21.9 (A2)
TRACE_CLK: U24.8 (A1)
TRACE_D0: U26.9 (A2)
TRACE_D1: U26.8 (A1)
TRACE_D2: U27.9 (A2)
TRACE_D3: U27.8 (A1)
VTREF: C64.1, C65.1, C66.1, C67.1, C68.1, C69.1, C70.1, C71.1, U20.6 (VCCB), U21.6 (VCCB), U22.6 (VCCB), U23.6 (VCCB), U24.6 (VCCB), U25.6 (VCCB), U26.6 (VCCB), U27.6 (VCCB)
VT_DEBUG_JTCK: R32.2
VT_DEBUG_JTDI: R36.2
VT_DEBUG_JTDO: R38.2
VT_DEBUG_JTMS: R34.2
VT_DEBUG_NRST: R42.2
VT_SPARE_IO0: R41.2
VT_SPARE_IO1: R43.2
VT_SPARE_IO2: R37.2
VT_SPARE_IO3: R39.2
VT_SPARE_IO4: R33.2
VT_SPARE_IO5: R35.2
VT_TRACE_CLK: R40.2
VT_TRACE_D0: R45.2
VT_TRACE_D1: R44.2
VT_TRACE_D2: R47.2
VT_TRACE_D3: R46.2
