Dakyodream/orbtrace_hw/hw/orbtrace_mini_bis_kicad/usb.kicad_sch

## KiCad design hw/orbtrace_mini_bis_kicad/usb.kicad_sch (2026-08-03)

Schematic: usb.kicad_sch

Parts:
C72, C73: 100nF; Voltage rating DC 10 V; Tolerance 10 %
C74: 1µF; Voltage rating DC 10 V; Tolerance 10 %
C75: 1µF; Voltage rating DC 4 V; Tolerance 10 %
F1: 500mA
J5: USB_C_Receptacle
R48: 20k; Tolerance 1 %
R49, R50: 5.1k; Tolerance 1 %
R51: 8.06k; Tolerance 1 %
R52: 10k; Tolerance 1 %
U28: USBLC6-2P6
U29: USB3343; QFN-24-1EP_4x4mm_P0.5mm_EP2.6x2.6mm

Connections:
+3.3V: C72.1, U29.2 (CLKOUT), U29.9 (VDDIO)
+5V: C73.1, F1.1, R48.1, U28.5 (VBUS), U29.16 (VBAT)
GND: C72.2, C73.2, C74.1, C75.1, J5.A1 (GND), J5.A12 (GND), J5.B1 (GND), J5.B12 (GND), J5.SH (SHIELD), R49.1, R50.1, R51.1, R52.1, U28.2 (GND), U29.25 (GND)
unnamed: C74.2, U29.15 (VDD33), U29.18 (ID)
unnamed: C75.2, U29.23 (VDD18)
unnamed: F1.2, J5.A4 (VBUS), J5.A9 (VBUS), J5.B4 (VBUS), J5.B9 (VBUS)
unnamed: J5.A5 (CC1), R49.2
unnamed: J5.B5 (CC2), R50.2
unnamed: R48.2, U29.17 (VBUS)
unnamed: R51.2, U29.19 (RBIAS)
ULPI_CLK: U29.21 (REFCLK/XI)
ULPI_DATA0: U29.4 (DATA0)
ULPI_DATA1: U29.5 (DATA1)
ULPI_DATA2: U29.6 (DATA2)
ULPI_DATA3: U29.7 (DATA3)
ULPI_DATA4: U29.8 (DATA4)
ULPI_DATA5: U29.10 (DATA5)
ULPI_DATA6: U29.11 (DATA6)
ULPI_DATA7: U29.12 (DATA7)
ULPI_DIR: U29.1 (DIR)
ULPI_NXT: U29.3 (NXT)
ULPI_RESET: R52.2, U29.22 (~RESETB)
ULPI_STP: U29.24 (STP)
USB_D_N: J5.A7 (D-), J5.B7 (D-), U28.1 (IO1), U28.6 (IO1), U29.14 (DM)
USB_D_P: J5.A6 (D+), J5.B6 (D+), U28.3 (IO2), U28.4 (IO2), U29.13 (DP)

Notes on the sheet:
MF-PSMF050X-2
Warning: 500 mA * 0.8 Ohm = 0.4 V 5V -> 4.6V
