Dakyodream/orbtrace_hw/(commit log)

2026-08-03 Schematic replica in KiCad
    Do not preserve component references.
    PCB and footprints are not managed.
    [connector_70p.kicad_sch, fpga_2.kicad_sch, fpga_3.kicad_sch, fpga_4.kicad_sch, fpga_5.kicad_sch, hyperram.kicad_sch, led.kicad_sch, orbtrace_mini_kicad_base.kicad_pcb]
2026-08-11 Schematic m26 run1 done
    Schematic / test point / components footprint done
    Todo :
    - PCB
    - Docmentations
    [CONNECTOR_EXT.kicad_sch, FPGA.kicad_sch, JTAG.kicad_sch, LEDs.kicad_sch, USB.kicad_sch, orbtrace_m26.kicad_pcb, orbtrace_m26.kicad_sch]
2026-08-12 Init PCB without error
    [CONNECTOR_EXT.kicad_sch, FPGA.kicad_sch, JTAG.kicad_sch, LEDs.kicad_sch, USB.kicad_sch, orbtrace_m26.kicad_pcb, orbtrace_m26.kicad_sch]
2026-08-12 WIP on PCB
    [USB.kicad_sch, orbtrace_m26.kicad_pcb]
